cmz488/CRTC_all/README.md

# **扬程战队的考核文档**
## *作者：扬程-蔡明铮*  
***

### 1. 我们是谁及组织架构
- **我们是谁？**

|  职务 |  姓名 |  专业  | 技术栈 |
|:-----:|:-----:|:----:|:---|
| 硬件/电控 | *商世博* | 未来信息 | *ST标准库* 裸机开发/基于*QT*的前端开发 |
| 机械/电控 | *蔡明铮* | 未来信息 | *ST标准库* 裸机开发/ _C++_ 和*python*基础 |
| 电控/硬件 | *袁骞*  | 未来信息 | *ST标准库*开发/C语言基础 |
| 机械/视觉 | *胡景乔* | 未来信息 | *HAL库*开发/*matlab*基础 |
- **组织架构**  

    就如表格所示，我们来自同一个专业，所学知识高度重合。基于两台机器人的规则，在第一次组会我们决定把我们分成两个小组，分别负责一号车和二号车的开发；同时鉴于我们都有一定的电控知识，我们采取分布式开发，基于ST标准库，将驱动源码分配到每一个人编写和调试。
- **第一次组会**  

    在第一次组会上我们定义了1，2号机器人的开发方向：

    | 机器人编号 | 功能方向                                     |
    |:-----:|:-----------------------------------------|
    |   1   | 负责弹丸的收集和携带（胜负关键）                         |
    |   2   | 负责协助1号机器人的任务，以提高搜集效率；  <br/>同时对敌方机器人进行干扰 |
- **扬帆启程**

    在确定方向后，我们投入学习并研发的过程中。

### 2. 想法起源
- #### **首方案的描述**

    对于1号机器人，既要收集，拥有较高的容量，又要较快的速度以保证高效的搜集速度，无疑这是高要求的。
不由，我们将目光投向外界。就在去虎溪培训的路上，看见虎溪的无人扫地机，灵感找上了我们。1号机器人的本质不就是扫地机器人吗？
迅速，我们制定了以滚刷为核心的的收集装置（v1.0.0）如图：————————
- #### **面临的技术难题和组织问题**
- #### **最终解决**
- #### **为什么抛弃首方案**
### 3. 迭代第二方案
- #### **各种想法的纠结**
- #### **最终想法的敲定**
- #### **技术难题**
- #### **难题的攻克**
- #### **方案的抛弃**
- #### **总结**
### 4. 第三方案的起草 （首方案的回归）
- #### **思想镣铐的突破**
- #### **难题的出现**
- #### ****
