cmz488/CRTC_all/图片/WIN_20251026_13_34_13_Pro.jpg

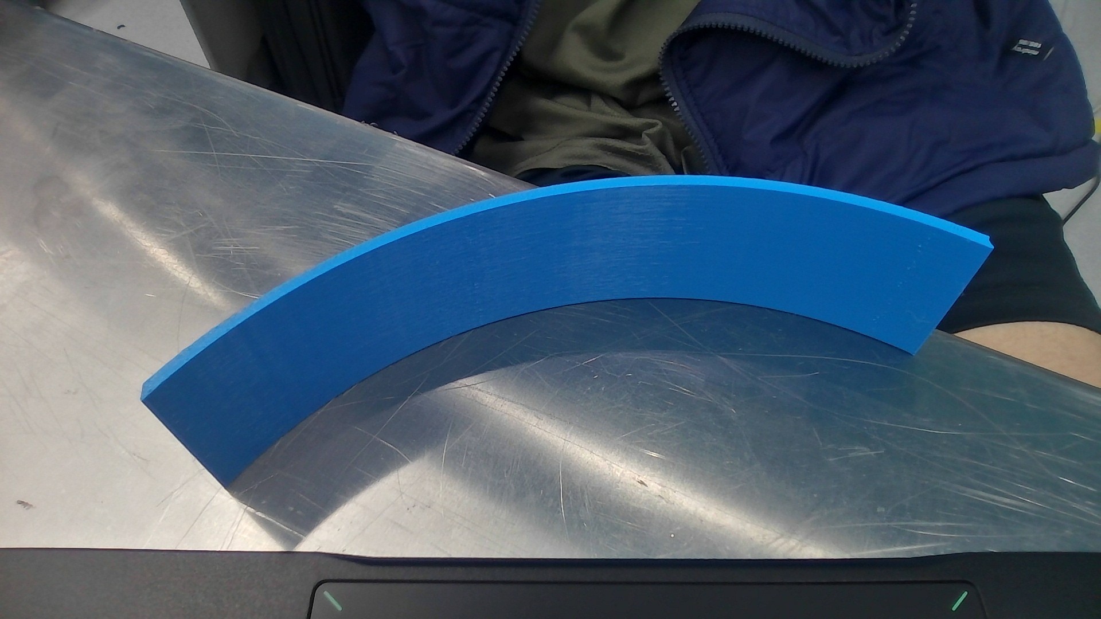
图片/WIN_20251026_13_34_13_Pro.jpg
