cmz488/CRTC_all/图片/小车建模图1.png

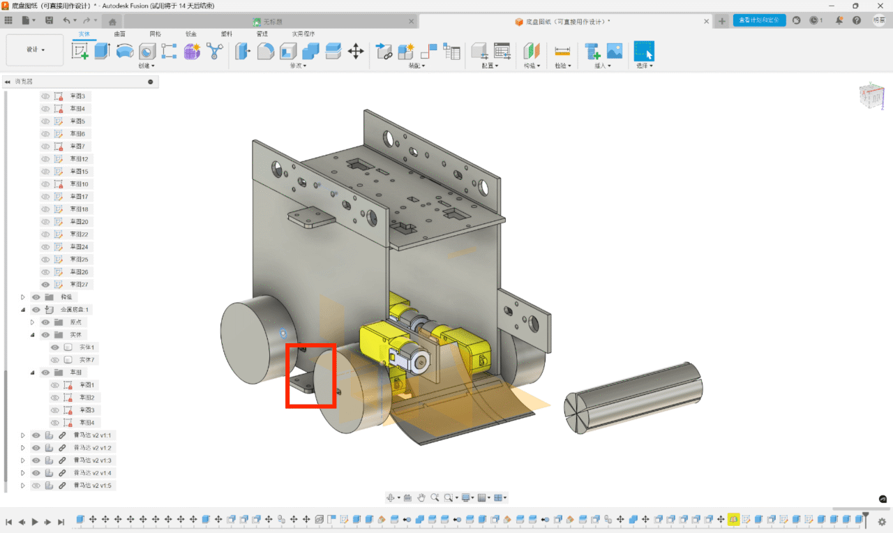
图片/小车建模图1.png
