cmz488/CRTC_all/图片/屏幕截图 2025-10-29 001216.png

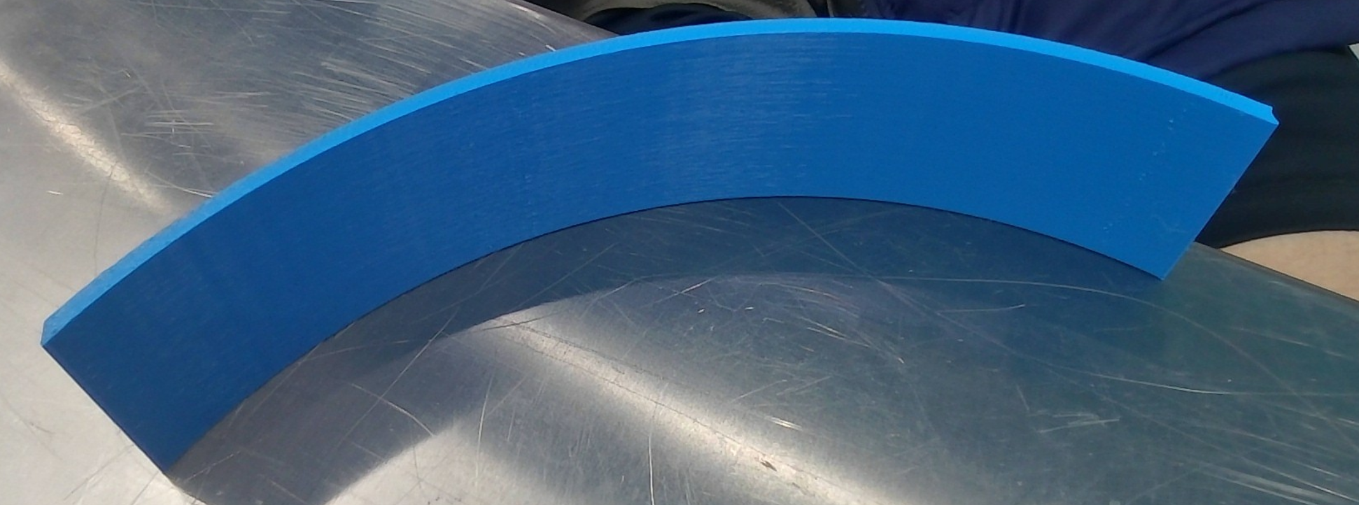
图片/屏幕截图 2025-10-29 001216.png
