cmz488/CRTC_all/docs/二号机器人开发日志.md

# **二号机器人的方案**
## ——一个干扰和辅助的“步兵机器人”
1. ***10.22号*** 经过对一号机器人的设计，我们对机器人的各个方面都有了熟练掌握。那么，正式对二号机器人的方向进行确立：
负责协助1号机器人的任务，以提高搜集效率；同时对敌方机器人进行干扰。建立在这样的基础上，我们设计了铲车模型，图片————
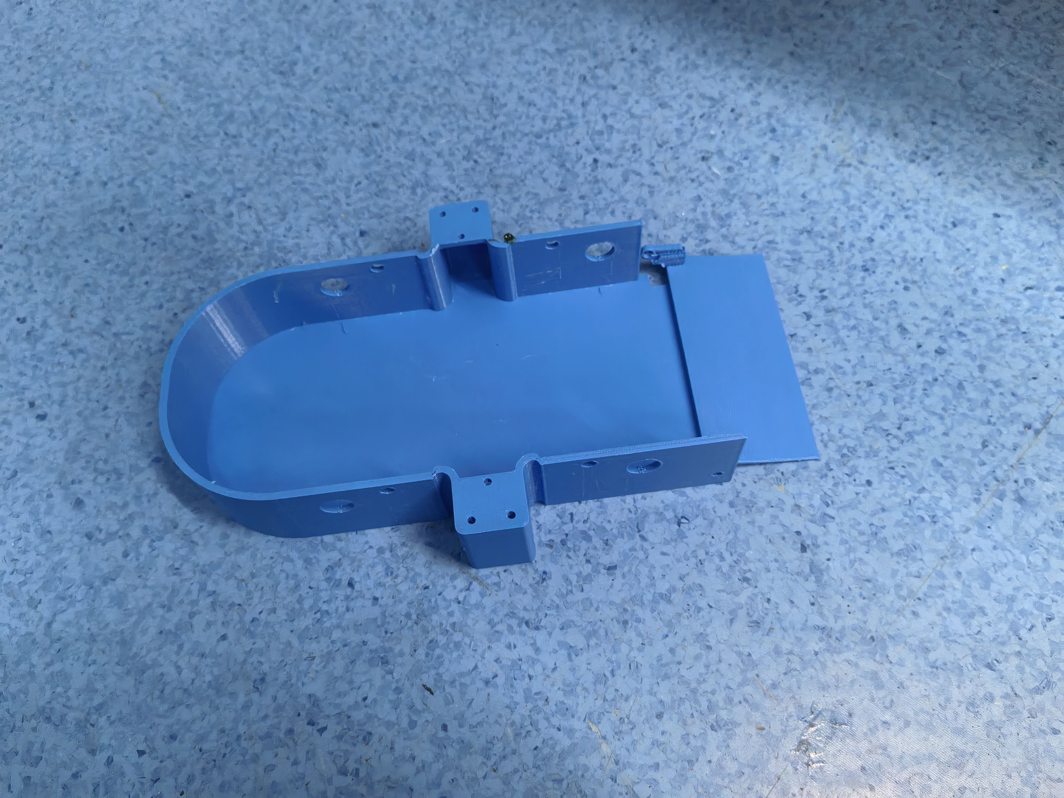
[picture p9: 图片/ECB10A4786FFDA7908D16BD8BDE0A601.jpg]
图片
 > 
  
***
# **TIM计时器**
## ——通过pwm波形控制舵机的转向角度
1. ***10.22号*** 为了实现铲斗的转动，
我们采用舵机操控的方式，TIM定时器配置如下：
  
    向下转45度

    | 寄存器 | 值       |
    |-----|---------|
    | PSC | 7200 -1 |
    | ARR | 100 -1  |
    | CCR | 5       |
      
    向上转45度  
    
    | 寄存器 | 值       |
    |-----|---------|
    | PSC | 7200 -1 |
    | ARR | 100 -1  |
    | CCR | 5       |  

2. **10.23号** 对ps2手柄控制舵机的代码进行编写，使用红灯模式
   按下绿色按钮会顺时针转动
   按下粉色按钮就会逆时针转动。

*** 

# **ps2控制麦轮**
1. ***10.23号*** 与一号机器人相同，详见《一号机器人开发日志》。
# u型铲斗
***10.25号*** 设计二号机器人方案2的u型铲斗，如图。
>WIN_20251026_13_34_13_Pro
***
将其安装在底盘上可以起到聚集地面的小球的作用。这样，二号车就可以将大量小球运送给一号车，从而辅助一号车的收集。
