cmz488/CRTC_all/(commit log)

2025-10-22 注释修饰
2025-10-22 删除了不必要文件
2025-10-25 图片上传
2025-10-25 更新图片，和上传markdown文档
2025-10-25 去除README.md，加入二号车图片
2025-10-26 Revise 二号机器人 development log entries
    Updated development log for 二号机器人 with new details on TIM timer configuration and PS2 control. Added design information for u型铲斗.
